manojeetc/Omnix/imgs/render-left.png

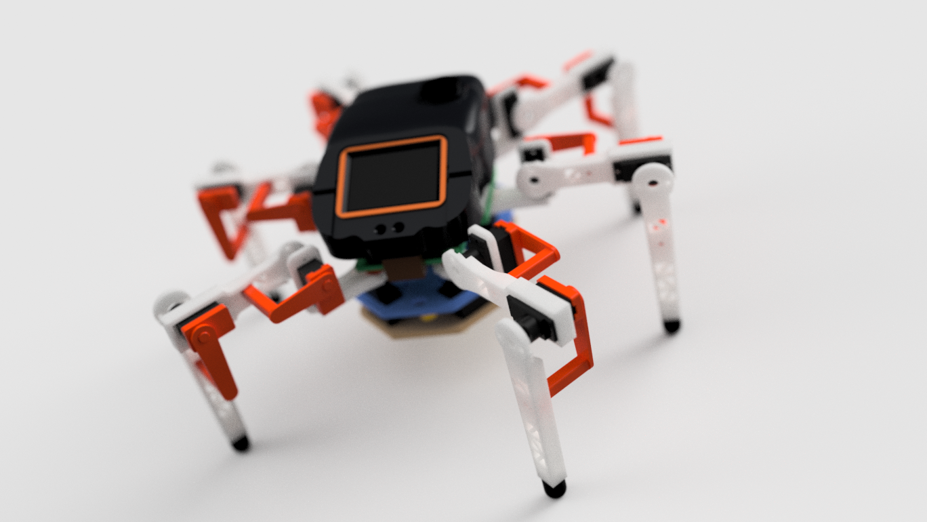
imgs/render-left.png
