manojeetc/Omnix/misc/BOM.xlsx

Quantity | Amount | Unit Cost | Supplier | Brand | Product URL | Total Cost | Notes
MG90S Servo | 18x | $2.80 | Amazon | Miuzei | View (https://www.amazon.com/dp/B0HHN4Z4G6) | $56.00 | Purchase more than 20 if possible (spares); 3 per leg, moves the leg, much cheaper than MG92B/others; can be replace w/ MG90D if wanted
2S 2200 LiPo | 1x | $15.30 | Amazon | Zeee | View (https://www.amazon.com/dp/B0CFLL8M9W) | $15.30 | Main power for the robot; any 2S 2200mAh battery should work
GY-521 MPU6050 | 1x | $2.90 | Amazon | EC Buying | View (https://www.amazon.com/dp/B0B3D6D1KD) | $8.60 | Measures angular velocity and linear acceleration; got MPU6500 instead of 6050
ESP-WROOM32 | 1x | $9.00 | Amazon | AITRIP | View (https://www.amazon.com/dp/B07WCG1PLV) | $9.00 | Main microcontroller
PCA9685 Servo Driver | 2x | $6.50 | Amazon | HUAREW | View (https://www.amazon.com/dp/B0CRV3MK14) | $13.00 | Powers all 18 servos, 9 per
240x320 2'' ST7789 SPI IPS TFT Screen | 1x | $10.00 | Amazon | NULLAB | View (https://www.amazon.com/dp/B0GVF8R5ZL) | $10.00 | Face of the robot; can use official Waveshare model, but more expensive and different wiring
15A UBEC | 1x | $20.00 | Amazon | ZTW | View (https://www.amazon.com/dp/B0D3FFXRRN) | $20.00 | Converts the LiPo charge to a safe current for servos, use a 15A UBEC to be safe
RP2350 Board | 1x | $7.00 | Amazon | Beetle | View (https://www.amazon.com/dp/B0F5PQMT6S) | $7.00 | Powers and controls the screen
5V 3A Buck | 1x | $1.50 | Amazon | AKEYSRC | View (https://www.amazon.com/dp/B0GYJDP96Q) | $9.00 | Converts the LiPo charge to a safe current for Beetle and ESP
2200uF 16V Capacitor | 2x | $1.00 | Amazon | Rubycon | View (https://www.amazon.com/dp/B0FVGBGMW2) | $7.00 | Makes current drops less dangerous for servos
12V 14AWG Fuse | 1x | $2.50 | Amazon | ecostm | View (https://www.amazon.com/dp/B0D9JDD2LY) | $5.00 | Protects the circuit against overvoltage
12V SPST Rocker Switch | 1x | $1.30 | Amazon | DaierTek | View (https://www.amazon.com/dp/B07S1MV462) | $6.40 | Turn the robot on and off w/o disconnecting the robot
200g TPU Filament | 1x | $11.00 | Amazon | Gizmo Dorks | View (https://www.amazon.com/dp/B07HR3XGNG) | $11.00 | Used to 3D print foot
1kg PLA Filament | 1x | $14.00 | Amazon | SUNLU | View (https://www.amazon.com/Printer-Filament-SUNLU-Dimensional-Accuracy/dp/B07XG3RM58?crid=SOR6OVU0RJYQ) | $14.00 | Used to 3D print chassis and robot body parts
1kg PETG Filament | 1x | $12.00 | Amazon | CC3D | View (https://www.amazon.com/CC3D-Standard-Filament-Transparent-Materials/dp/B0D91G9ZW3?crid=1DN6A109XVTDL) | $12.00 | Used to 3D print leg parts
M3 Screws Assortment | 1x | $9.00 | Amazon | VGBUY | View (https://www.amazon.com/dp/B0D1XJ766V) | $9.00 | Used to assemble robot
M2.5 Screws Assortment | 1x | $10.00 | Amazon | Fgruh | View (https://www.amazon.com/dp/B0FG2BYJSR) | $10.00 | Used to assemble robot
DuPont Cables Assortment | 1x | $7.00 | Amazon | ELEGOO | View (https://www.amazon.com/dp/B01EV70C78) | $7.00 | Used for various wirings
20ft 22 AWG Wires | 1x | $6.00 | Amazon | Haerkn | View (https://www.amazon.com/Electrical-Gauge-Silicone-Cable-Black/dp/B0746HG158?crid=10ZJJ4L3DT2YW) | $6.00 | Used for breadboard-related wirings
20ft 18 AWG Wires | 1x | $8.00 | Amazon | Haerkn | View | $8.00 | Used for power wiring
Resistors Assortment | 1x | $6.40 | Amazon | LuminologyPro | View (https://www.amazon.com/LuminologyPro-1000-Piece-Resistor-25-Value-1%CE%A9-1M%CE%A9/dp/B0F4P352BB) | $6.40 | Used for battery monitor and others
 |  |  |  |  |  | Grand Total: | Includes full filament spools, screw assortments, wire, and other bulk materials; significant leftovers remain after one build.
 |  |  |  |  |  | $249.70
