manojeetc/Omnix/cad/step/tibia_V5.step

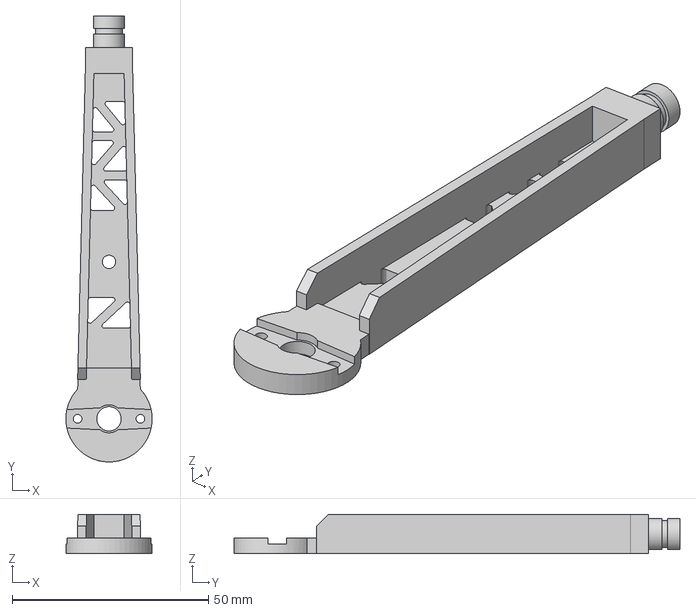
[picture p10: CAD file, 2026-10-11]
cad/step/tibia_V5.step
22.0 x 113.6 x 10.0 mm
