manojeetc/Omnix/cad/step/bottom_plate_V4.step

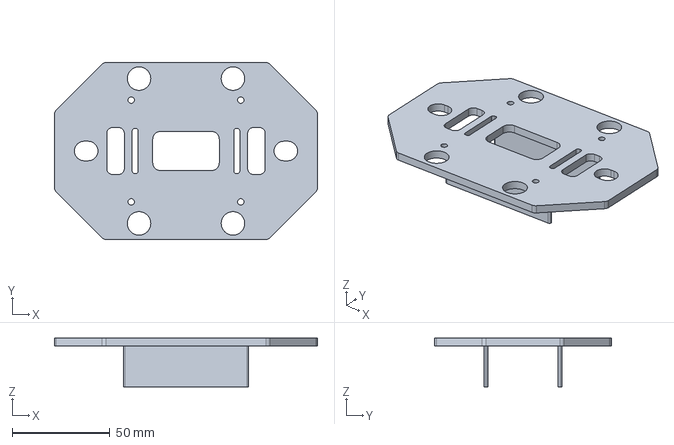
[picture p11: CAD file, 2026-10-11]
cad/step/bottom_plate_V4.step
134.4 x 90.4 x 25.0 mm
