manojeetc/Omnix/cad/step/femur_bracket_V6.step

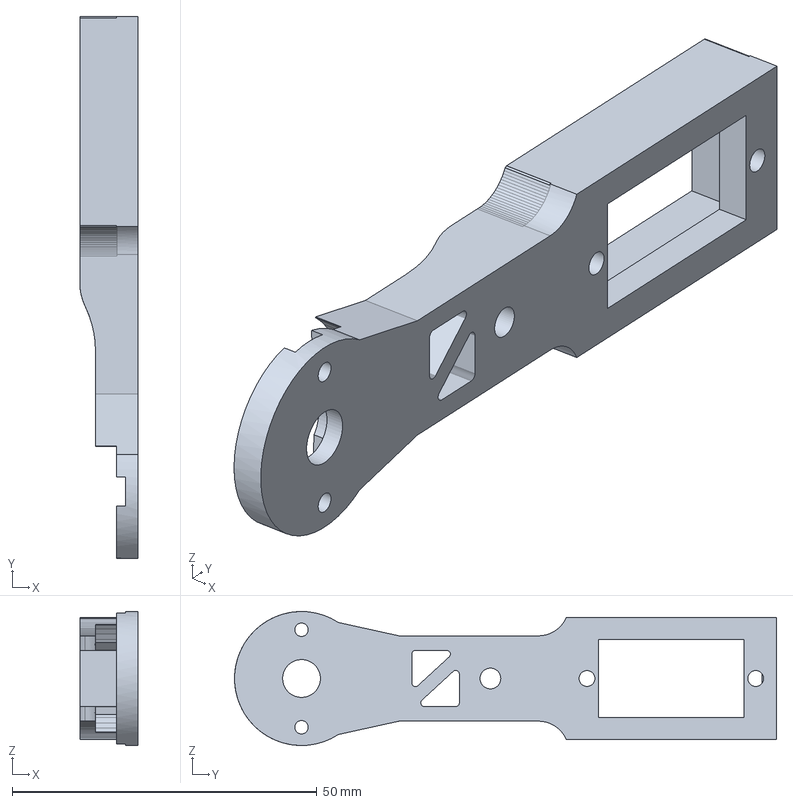
[picture p12: CAD file, 2026-10-11]
cad/step/femur_bracket_V6.step
9.60 x 89.0 x 22.0 mm
