manojeetc/Omnix/cad/step/screen_base.step

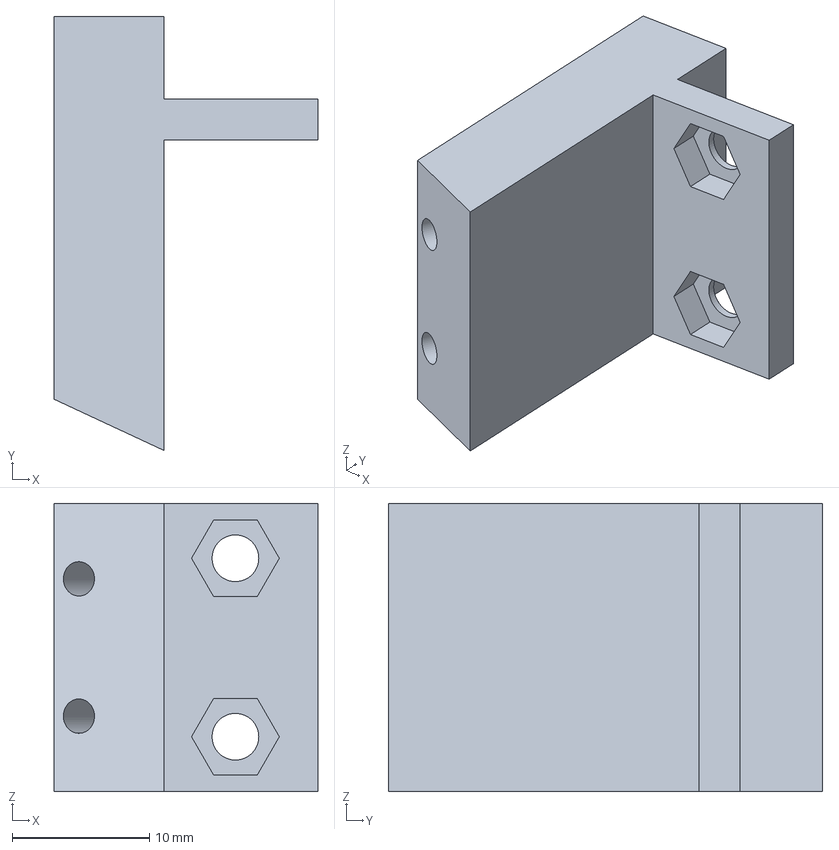
[picture p13: CAD file, 2026-10-11]
cad/step/screen_base.step
19.2 x 31.6 x 21.0 mm
