manojeetc/Omnix/cad/step/head_front_clip.step

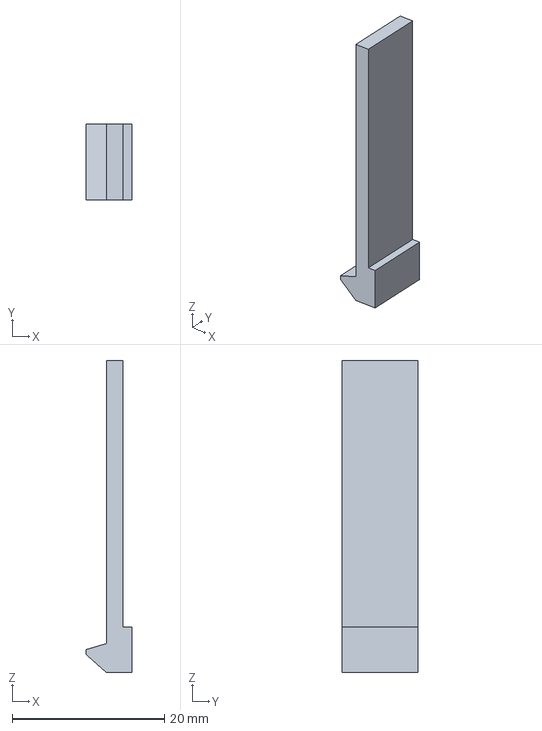
[picture p14: CAD file, 2026-10-11]
cad/step/head_front_clip.step
6.10 x 10.0 x 41.0 mm
