manojeetc/Omnix/cad/step/standoff_M3x14.step

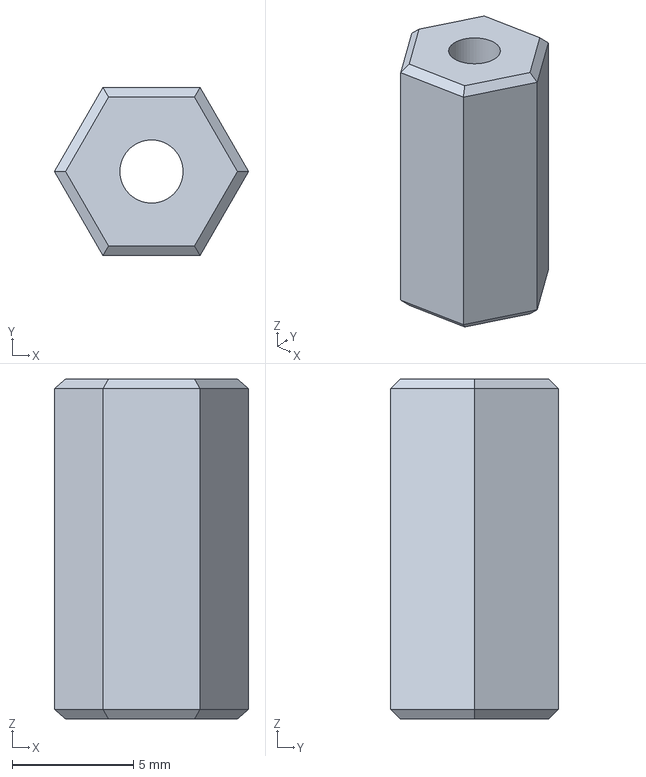
[picture p15: CAD file, 2026-10-11]
cad/step/standoff_M3x14.step
8.00 x 6.93 x 14.0 mm
