manojeetc/Omnix/cad/step/foot_cap_TPU.step

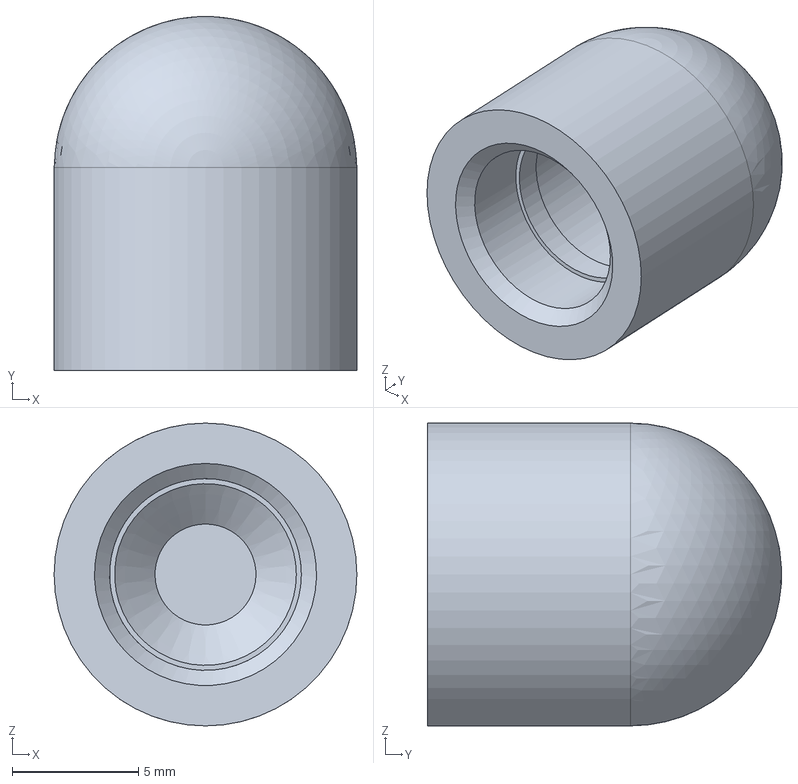
[picture p16: CAD file, 2026-10-11]
cad/step/foot_cap_TPU.step
12.0 x 14.0 x 12.0 mm
