manojeetc/Omnix/cad/step/top_deck_V3.step

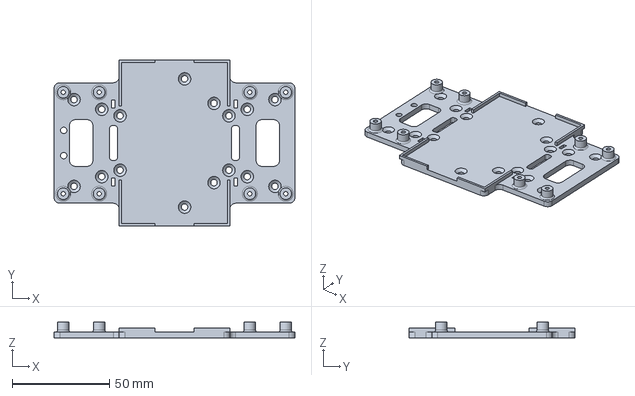
[picture p17: CAD file, 2026-10-11]
cad/step/top_deck_V3.step
124.0 x 85.2 x 7.99 mm
