manojeetc/Omnix/cad/step/screen_frame_V4.step

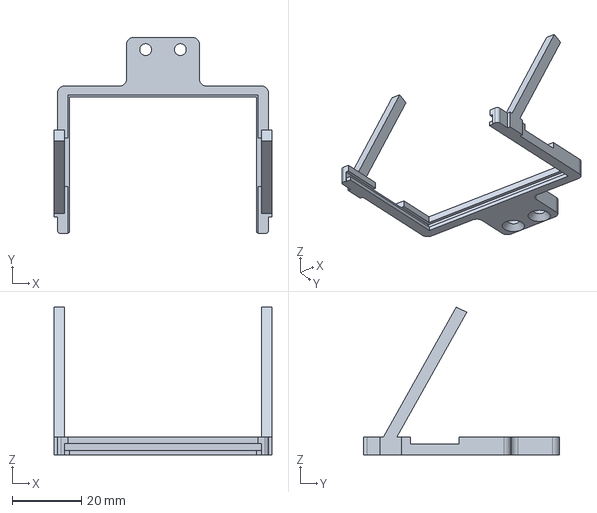
[picture p18: CAD file, 2026-10-11]
cad/step/screen_frame_V4.step
62.8 x 56.5 x 42.5 mm
