manojeetc/Omnix/cad/step/coxa_bracket_V5.step

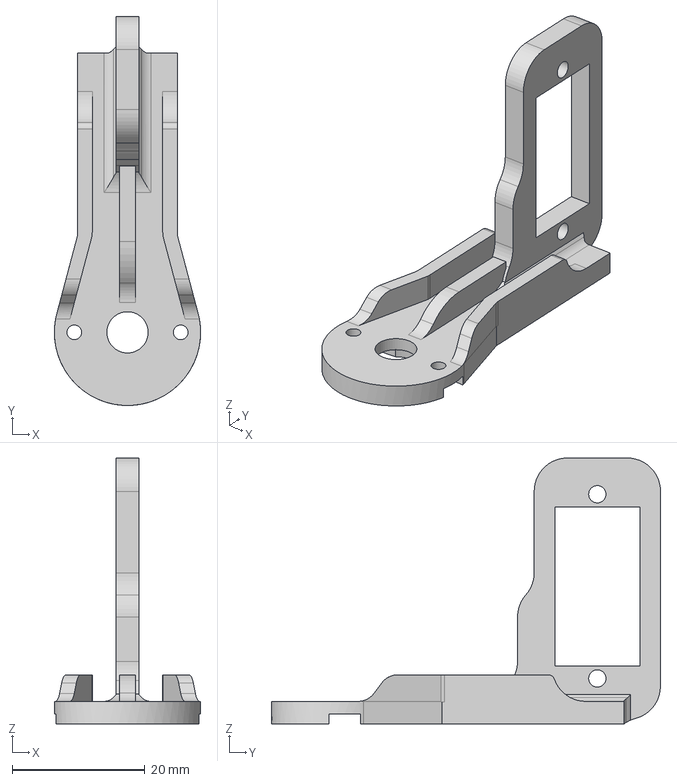
[picture p19: CAD file, 2026-10-11]
cad/step/coxa_bracket_V5.step
22.0 x 58.5 x 40.0 mm
