manojeetc/Omnix/cad/step/head_hood_v2.step

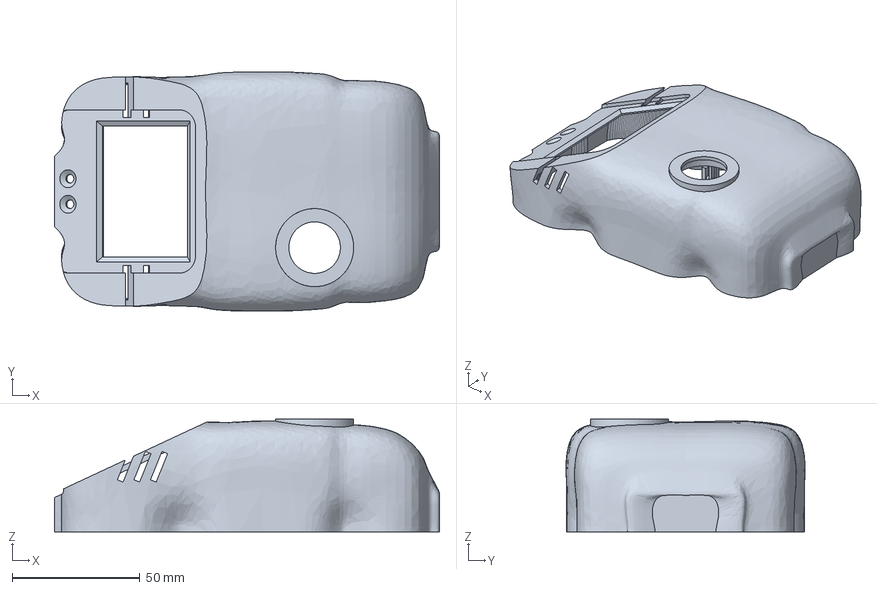
[picture p20: CAD file, 2026-10-11]
cad/step/head_hood_v2.step
151.0 x 93.7 x 44.1 mm
