manojeetc/Omnix/cad/step/knee_inner_link.step

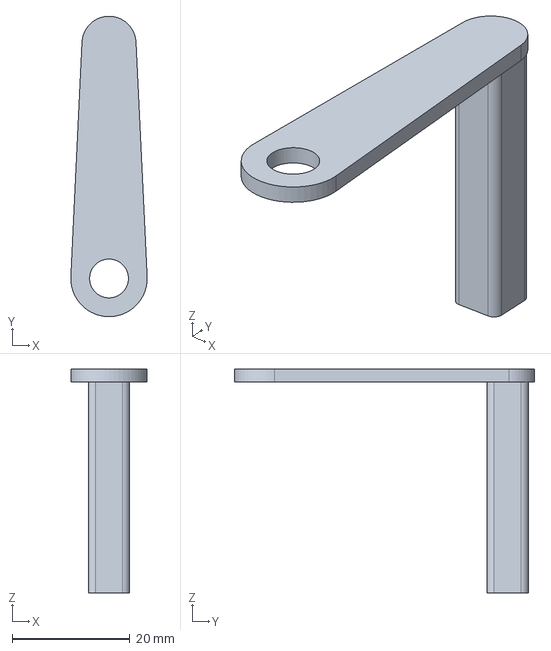
[picture p21: CAD file, 2026-10-11]
cad/step/knee_inner_link.step
13.0 x 51.1 x 38.1 mm
