manojeetc/Omnix/cad/step/standoff_M3x25.step

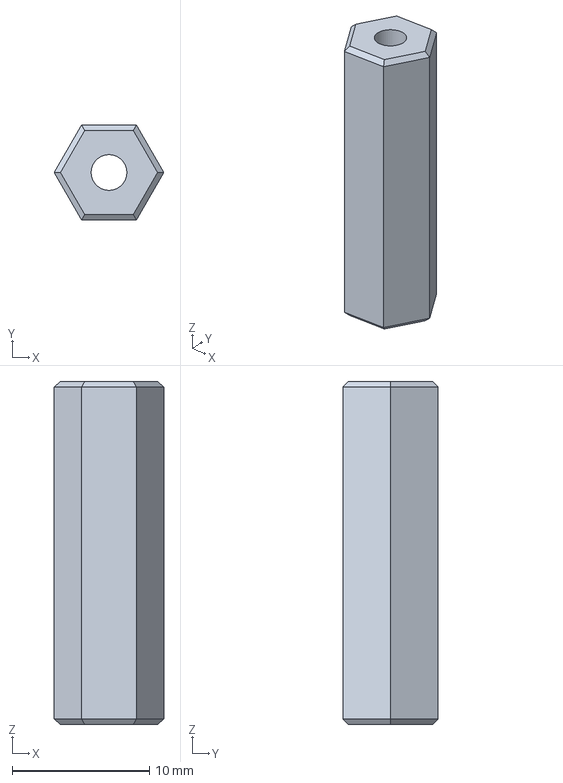
[picture p22: CAD file, 2026-10-11]
cad/step/standoff_M3x25.step
8.00 x 6.93 x 25.0 mm
