manojeetc/Omnix/cad/step/servo_cap.step

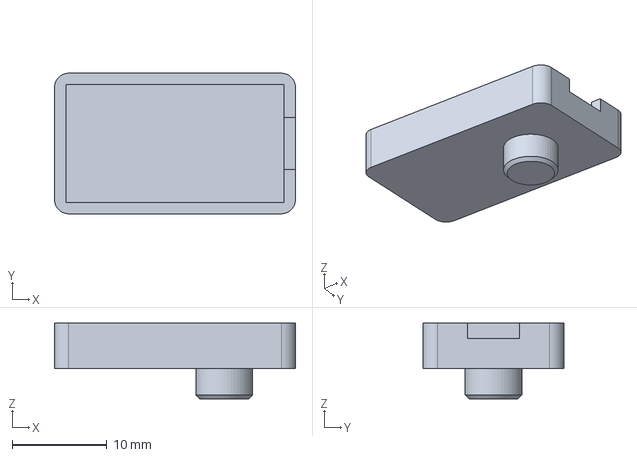
[picture p23: CAD file, 2026-10-11]
cad/step/servo_cap.step
25.4 x 14.8 x 8.00 mm
