manojeetc/Omnix/cad/step/hip_inner_link.step

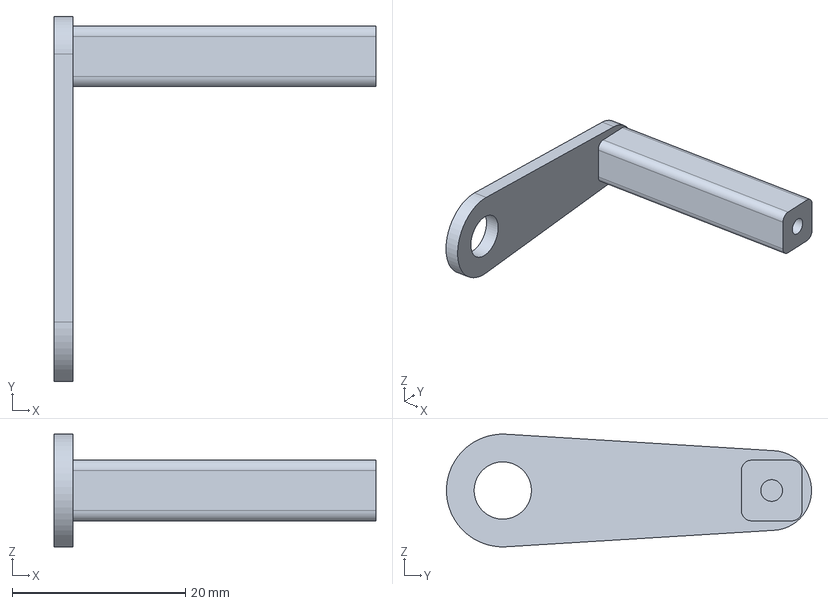
[picture p24: CAD file, 2026-10-11]
cad/step/hip_inner_link.step
37.1 x 42.1 x 13.0 mm
