manojeetc/Omnix/cad/step/head_visor_v2.step

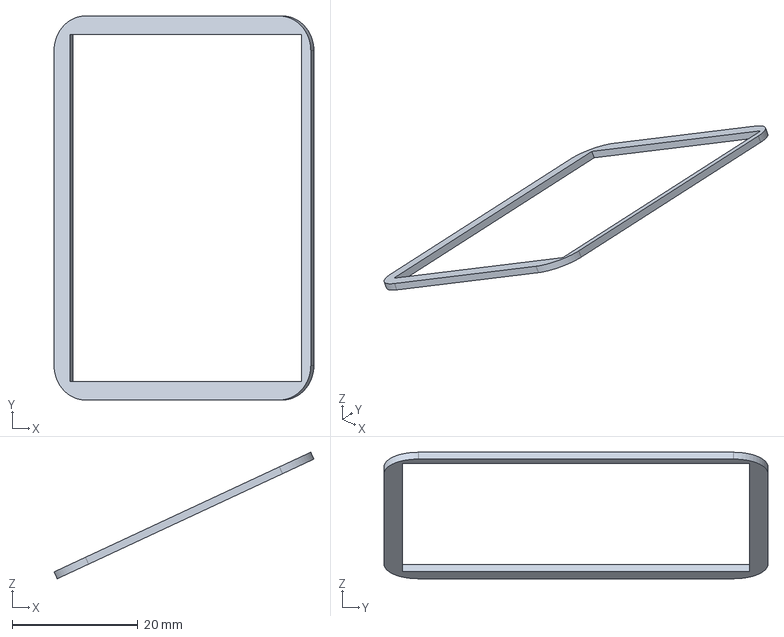
[picture p25: CAD file, 2026-10-11]
cad/step/head_visor_v2.step
41.3 x 61.0 x 20.1 mm
