manojeetc/Omnix/cad/step/chassis_V4.step

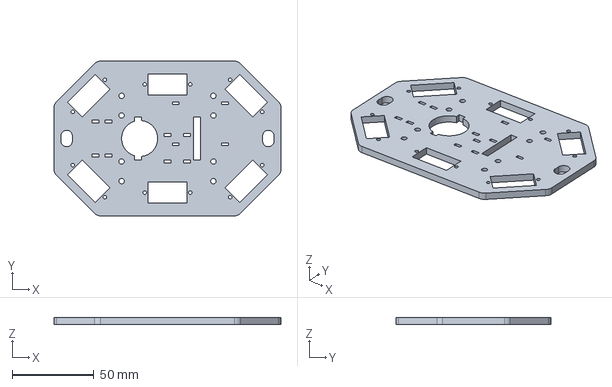
[picture p26: CAD file, 2026-10-11]
cad/step/chassis_V4.step
138.4 x 94.4 x 4.00 mm
