manojeetc/Omnix/(list of files, cad)

Other CAD files:
cad/stl/bottom_plate_V4.stl
cad/stl/chassis_V4.stl
cad/stl/coxa_bracket_V5.stl
cad/stl/femur_bracket_V6.stl
cad/stl/foot_cap_TPU.stl
cad/stl/head_front_clip.stl
cad/stl/head_hood_v2.stl
cad/stl/head_visor_v2.stl
cad/stl/hip_inner_link.stl
cad/stl/knee_inner_link.stl
cad/stl/screen_base.stl
cad/stl/screen_frame_V4.stl
cad/stl/servo_cap.stl
cad/stl/standoff_M3x14.stl
cad/stl/standoff_M3x25.stl
cad/stl/tibia_V5.stl
cad/stl/top_deck_V3.stl
