manojeetc/Omnix/(commit log)

2026-10-11 add cad files
    [bottom_plate_V4.step, chassis_V4.step, coxa_bracket_V5.step, femur_bracket_V6.step, foot_cap_TPU.step, head_front_clip.step, head_hood_v2.step, head_visor_v2.step]
2026-10-11 add stuff
    [BOM.xlsx, bottom_plate_V4.step, chassis_V4.step, coxa_bracket_V5.step, femur_bracket_V6.step, foot_cap_TPU.step, head_front_clip.step, head_hood_v2.step]
2026-10-11 add assembly instructions
2026-10-11 add stl files and challenges
    [bottom_plate_V4.step, bottom_plate_V4.stl, chassis_V4.step, chassis_V4.stl, coxa_bracket_V5.step, coxa_bracket_V5.stl, femur_bracket_V6.step, femur_bracket_V6.stl]
